integratorsb/ndds/hw/pcb_v4.JPG

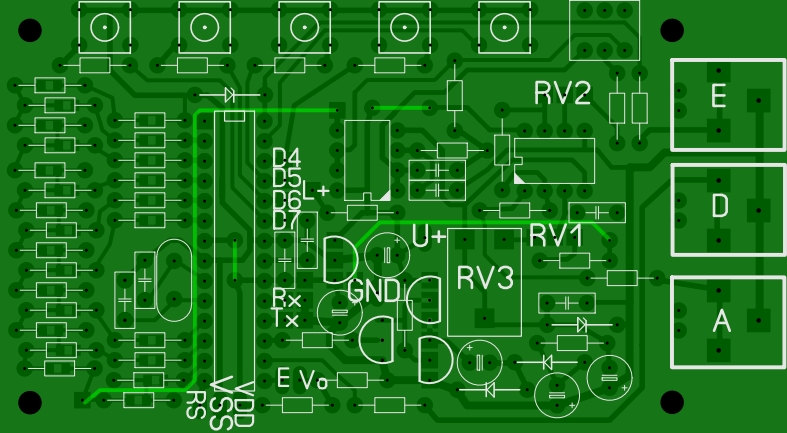
hw/pcb_v4.JPG
