integratorsb/ndds/version.txt

v0.17 - 16.06.2018
	Добавлен генератор импульсной последовательности(DPATTERN)
	Исправлен баг в алгоритме PULSE
	Переделана инициализаци портов
	Оптимизация кода

v0.16 - 20.12.2017
	Добавлен свип-генератор(SWEEP)
	Доработан генератор ТВ сигнала
	Исправлена ошибка со сбросом порта в режиме ШУМ(NOISE)
	Сделан сброс настроек для прошивки с энкодером
	Оптимизация кода(таблицы пилы и треугольника теперь генерируются математическим методом)

v0.15 - 4.11.2017
	Добавлен генератор двухтонального сигнала(DTMF)
	Сделана версия прошивки с энкодером
	Оптимизация кода
	На порт PB5 выводится лог. 0 при работе в аналоговом режиме и 1 в цифровом
	- Отключен программный UART

v0.14 - 17.10.2017 
	Исправлена ошибка с инициализацией ШИМ
	Режим работы генератора теперь можно выбирать кнопками +/- 
	
v0.13 - 29.09.2017 
	Исправлен баг с переполнением в режимах с DDS
	Исправлен баг с делителем ШИМ
	Добавлено ещё 2 ТВ сигнала(сетка и клетчатое поле)
	В режиме ШИМ(без синхронизации) теперь можно менять частоту и скважность во время работы генератора

v0.12 - 19.09.2017 
	Исправлено несколько багов

v0.11 - 10.09.2017 
	Исправлен глюк кнопок
	Добавлена возможность запуска по внешнему сигналу в режим pulse
	Добавлена возможность внешней синхронизации в режим pwm
	Оптимизация кода

v0.1 - 27.07.2017 
	Первая версия
