integratorsb/ndds/hw/dds_sg_1.png

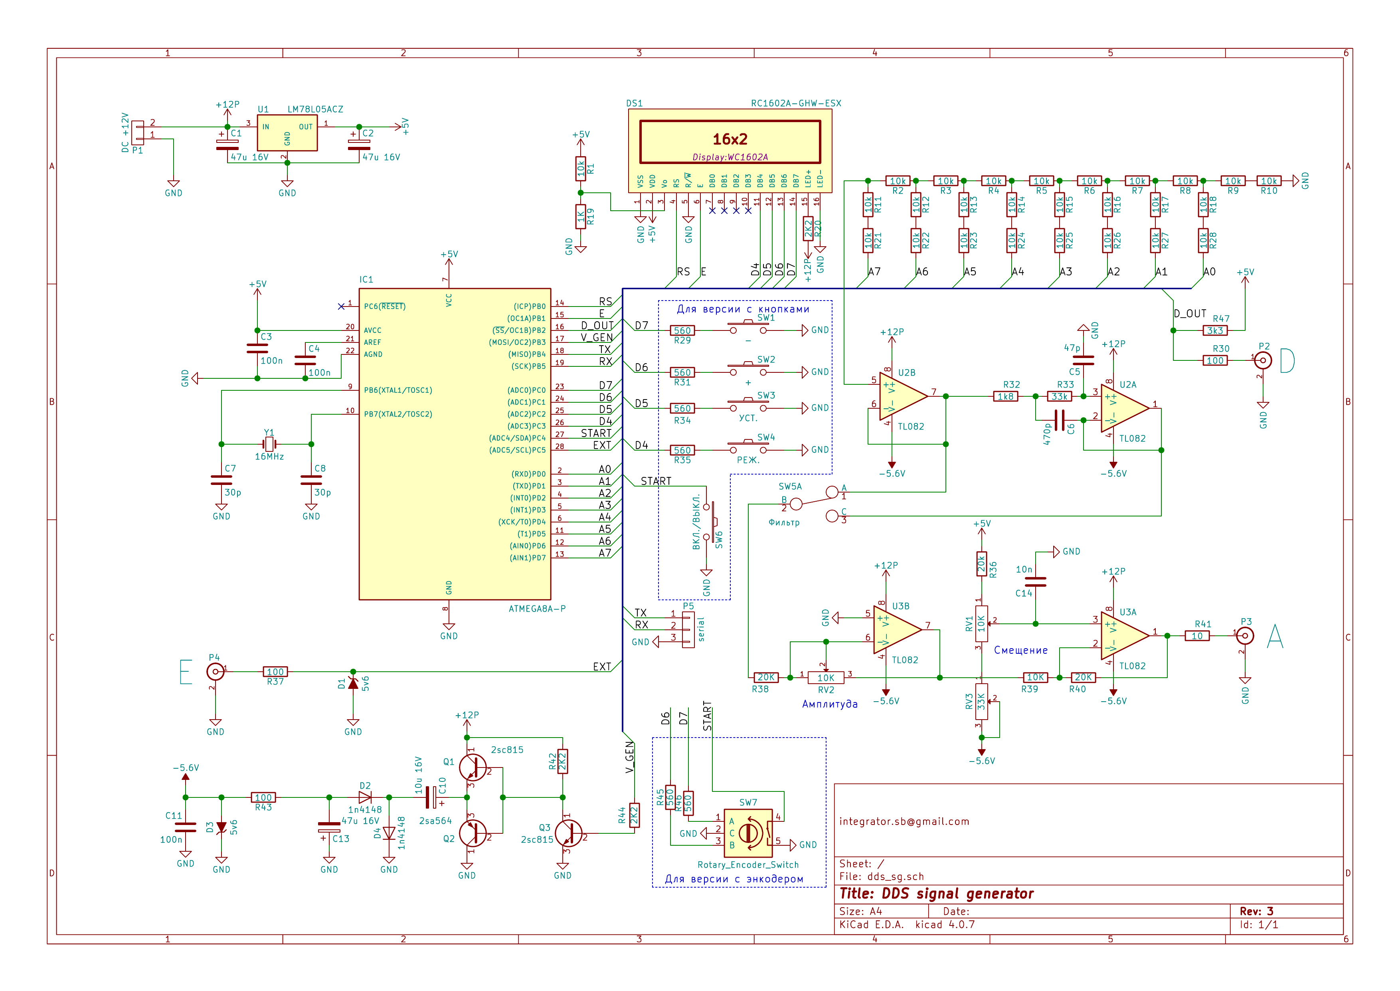
hw/dds_sg_1.png
