integratorsb/ndds/hw/dds_sg.pdf

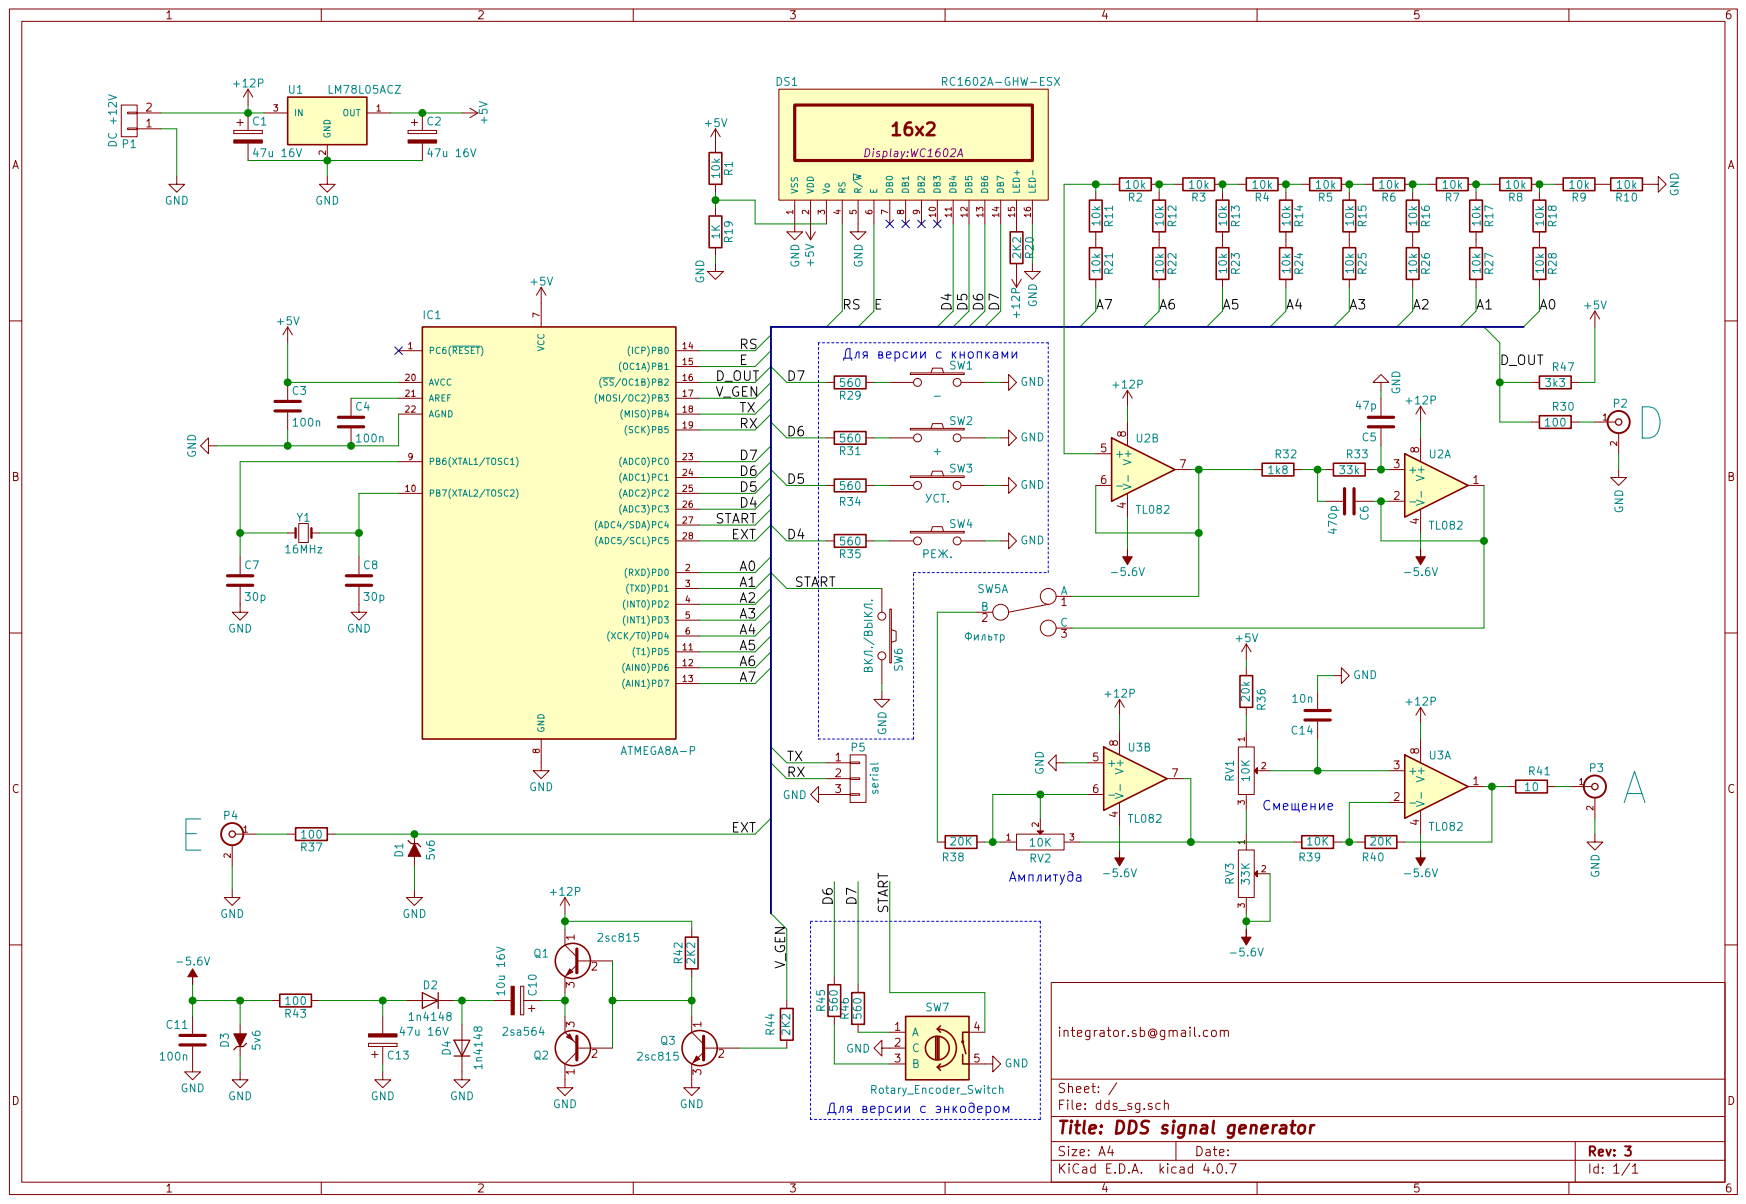
[picture p3: page 1]
