integratorsb/ndds/(list of files, drawings)

Other design files:
hw/pcb_v5.lay
