integratorsb/ndds/main.c

/*
 * main.c
 *
 * Created: 10.07.2017 1:17:10
 *  Author: integrator.sb@gmail.com
 */ 

#include "config.h"
//#include <stdio.h>
#include <stdlib.h>
#include <avr/io.h>
#include <avr/pgmspace.h>
#include <avr/eeprom.h>
#include <avr/interrupt.h>
#include <util/delay.h>
#include <inttypes.h>
#include "hd44780.h"
#include "menu.h"
#include "suart.h"
#include "dds_rout.h"
#include "TV_video_generator.h"


const gen_t PROGMEM def_setting = DEF_SETTING;
gen_t EEMEM setting = DEF_SETTING;
EEMEM uint8_t e_pattern[256] = DEF_DPATTERN;

uint8_t __attribute__ ((section (".buffer"))) buf[256]; 


const uint8_t  sinewave[] PROGMEM= 
{
	0x80,0x83,0x86,0x89,0x8c,0x8f,0x92,0x95,0x98,0x9c,0x9f,0xa2,0xa5,0xa8,0xab,0xae,
	0xb0,0xb3,0xb6,0xb9,0xbc,0xbf,0xc1,0xc4,0xc7,0xc9,0xcc,0xce,0xd1,0xd3,0xd5,0xd8,
	0xda,0xdc,0xde,0xe0,0xe2,0xe4,0xe6,0xe8,0xea,0xec,0xed,0xef,0xf0,0xf2,0xf3,0xf5,
	0xf6,0xf7,0xf8,0xf9,0xfa,0xfb,0xfc,0xfc,0xfd,0xfe,0xfe,0xff,0xff,0xff,0xff,0xff,
	0xff,0xff,0xff,0xff,0xff,0xff,0xfe,0xfe,0xfd,0xfc,0xfc,0xfb,0xfa,0xf9,0xf8,0xf7,
	0xf6,0xf5,0xf3,0xf2,0xf0,0xef,0xed,0xec,0xea,0xe8,0xe6,0xe4,0xe2,0xe0,0xde,0xdc,
	0xda,0xd8,0xd5,0xd3,0xd1,0xce,0xcc,0xc9,0xc7,0xc4,0xc1,0xbf,0xbc,0xb9,0xb6,0xb3,
	0xb0,0xae,0xab,0xa8,0xa5,0xa2,0x9f,0x9c,0x98,0x95,0x92,0x8f,0x8c,0x89,0x86,0x83,
	0x80,0x7c,0x79,0x76,0x73,0x70,0x6d,0x6a,0x67,0x63,0x60,0x5d,0x5a,0x57,0x54,0x51,
	0x4f,0x4c,0x49,0x46,0x43,0x40,0x3e,0x3b,0x38,0x36,0x33,0x31,0x2e,0x2c,0x2a,0x27,
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
	#endif
	
	//DDRC =  0<<EXT_PIN;
	PORTC = BTN_MASK | 0<<EXT_PIN;
	
	//R2RPORT = 0;
	//R2RDDR = 0xff;
}


inline void noise_start()
{
	while(!btnCheck(BTN_START))
	{
		R2RPORT = rand();
	}
	io_to_default();
}

void pwm_stop()
{
	TCCR1A = 0;
	TCCR1B = 0;
	io_to_default();
}


void pwm_start(uint32_t freq, uint8_t d, uint8_t e )
{
	uint32_t period;
	uint8_t cntr;
	
	
	//fast PWM	
	TCCR1A |= (1<<WGM11);
	TCCR1B |= (1<<WGM13)  | (1<<WGM12);

	period = (F_CPU/freq) - 1;	
	
	cntr = (TCCR1B & 0b11111000);

	if(period < 0xffff)
	{
		
		//cntr = (TCCR1B & 0b11111000) | (1<<CS10);//без делителя
		cntr |= (1<<CS10);//без делителя
	}
	else
	{
		period /= 256;
		//cntr = (TCCR1B & 0b11111000) | (1<<CS12);//делитель 256
		cntr |= (1<<CS12);//делитель 256
		
	}
	
	ICR1 = (uint16_t)period;
	OCR1B =  (uint16_t)(period * d / 100);	
	TCCR1B = cntr;
	
	TCCR1A |= (1<<COM1B1);

	//	if(e == EXT_NO)
	//		return;
	if(e == EXT_HIGH)
	{
		while(!btnCheck(BTN_START))
		{
			if((EXT_PINS & EXT_PIN_MSK) != 0)
				TCCR1A |= 1<<COM1B1;
			else
				TCCR1A &= ~(1<<COM1B1);
		}
	}
	else if(e == EXT_LOW)
	{
		while(!btnCheck(BTN_START))
		{
			if((EXT_PINS & EXT_PIN_MSK) == 0)
				TCCR1A |= 1<<COM1B1;
			else
				TCCR1A &= ~(1<<COM1B1);
		}
	}
	//else return;
	//pwm_stop();
}

uint8_t pwm_is_run() 
{
	return (TCCR1B != 0);
}

uint32_t get_phase_f(uint32_t f)
{
	//return ((uint64_t)f << 16) / (F_CPU/NUM_CYCLES/0x100);
	//return (((uint64_t)f<<24 )/(F_CPU/NUM_CYCLES));	
	return (((uint64_t)f * (0x1000000*NUM_CYCLES) )/F_CPU);

}

inline void dds_start(uint32_t f)
{

	dds(get_phase_f(f));
	io_to_default();
}

inline void ddssq_start(uint32_t f)
{

	//HSPORT &= ~(1<<HSPIN);
	//HSDDR |= 1<<HSPIN;
	dds_sq(get_phase_f(f) * 2);
	//HSPORT &= ~(1<<HSPIN);
	//HSDDR &= ~(1<<HSPIN);
	io_to_default();

}


void get_phase_t( uint32_t *p, uint32_t *t)
{
/*
	 T0 = 1000000<<16 / (F_CPU / NUM_CYCLES)
	 P = 1<<24 / (T<<16 / T0)*/
	//*p =  0x1000000/(((uint64_t)*t<<16)/((uint64_t)(1000000<<16) / (F_CPU / NUM_CYCLES)));
	//*p =  0x1000000/(((uint64_t)*t<<16)/36864);	
	//*p = ((1000000 * (uint64_t)NUM_CYCLES * 0x1000000) / F_CPU) / *t;
	*p = ((1000000 * (uint64_t)NUM_CYCLES * 0x100000000) / F_CPU) / *t;
	
}

inline void pulse_start()
{
	pulse_t pulse_s;
	
	get_phase_t(&pulse_s.t_rise, &generator.pulse_t_rise);
	get_phase_t(&pulse_s.t_on,&generator.pulse_t_on);
	get_phase_t(&pulse_s.t_fall,&generator.pulse_t_fall);
	get_phase_t(&pulse_s.t_off,&generator.pulse_t_off);
	pulse_s.n = generator.pulse_n;
	pulse(&pulse_s);
	io_to_default();

}

inline uint8_t trig_wait_rise()
{
	while((EXT_PINS & EXT_PIN_MSK) != 0)
	{
		if(btnCheck(BTN_START)) return 0;
	}
	while((EXT_PINS & EXT_PIN_MSK) == 0)
	{
		if(btnCheck(BTN_START)) return 0;
	}
	return 1;
}

inline uint8_t  trig_wait_fall() 
{
	while((EXT_PINS & EXT_PIN_MSK) == 0)
	{
		if(btnCheck(BTN_START)) return 0;
	}
	while((EXT_PINS & EXT_PIN_MSK) != 0)
	{
		if(btnCheck(BTN_START)) return 0;
	}
	return 1;
}

void save_mode()
{
	eeprom_update_byte(&setting.m, generator.m);
}

void mode_select(uint8_t btn)
{

	if(btn == BTN_MODE || btn == BTN_UP)
		generator.m++;
	else if(btn == BTN_DOWN)
	{
		if(generator.m == 0)
			generator.m = M_VER;
		else
			generator.m--;
	}
}

void load_table(const uint8_t* src)
{
	memcpy_P(&buf, src, sizeof(buf));
}


inline void dtmf_start()
{
	load_table(sinewave);
	
	dtmf((uint64_t)(generator.dtmf_f1<<16) /(F_CPU/21/0x100), \
	(uint64_t)(generator.dtmf_f2<<16) /(F_CPU/21/0x100));
	io_to_default();
}



void dds_main(const char* t, uint32_t* f, uint32_t* f_save)
{
	uint8_t btn;
	
	#ifdef USE_OMUX
		omux_clr();
	#endif
	nnl_puts_P(t);
	print_on_off(0);			
	print_fq(*f);
	btn = btn_wait();
	if(btn == BTN_START)
	{
		btn_wait_up_start();
		eeprom_update_dword(f_save, *f);
		save_mode();
		print_on_off(1);
		dds_start(*f);
		btn_wait_up_start();
	}
	else if(btn == BTN_SET)
	{
		input_f(f);
	}
	mode_select(btn);
}

inline void noise_main()
{
	uint8_t btn;
	
	#ifdef USE_OMUX
		omux_clr();
	#endif
	nnl_puts_P(PSTR("\rNOISE "));
	print_on_off(0);
	
	btn = btn_wait();
	if(btn == BTN_START)
	{
		btn_wait_up_start();
		save_mode();
		print_on_off(1);
		noise_start();
		btn_wait_up_start();
	}
	mode_select(btn);
}

inline void sqw_main()
{
	uint8_t btn;
	
	#ifdef USE_OMUX
	omux_set();
	#endif
	nnl_puts_P(PSTR("\rSQUARE WAVE"));
	print_on_off(0);
	print_fq(generator.f_sqw);
						
	btn = btn_wait();
	if(btn == BTN_START)
	{
		btn_wait_up_start();
		save_mode();
		eeprom_update_dword(&setting.f_sqw, generator.f_sqw);

		print_on_off(1);
		ddssq_start(generator.f_sqw);
		btn_wait_up_start();
	}
	else if(btn == BTN_SET)
	{
		input_f(&generator.f_sqw);
	}
	mode_select(btn);
}

inline void pwm_main()
{
	uint8_t btn;
	
	#ifdef USE_OMUX
	omux_set();
	#endif
	io_to_default();
	//st = pwm_is_run();
	
	nnl_puts_P(PSTR("\rPWM"));
	print_on_off(pwm_is_run());
	print_fq(generator.pwm_f);
	nnl_puts_P(PSTR(" D="));
	print_u8(generator.pwm_d);
	if(generator.pwm_sync == EXT_HIGH)
		nnl_puts_P(PSTR(" E=H"));
	else if(generator.pwm_sync == EXT_LOW)
		nnl_puts_P(PSTR(" E=L"));
					
	btn = btn_wait();
	if(btn == BTN_START)
	{
		btn_wait_up_start();
						
		if( pwm_is_run())
		{
			pwm_stop();
		}
		else
		{

			print_on_off(1);
			pwm_start(generator.pwm_f, generator.pwm_d, generator.pwm_sync );
			save_mode();
			eeprom_update_block(&generator.pwm_f,&setting.pwm_f, 1+4+1);
		}
	}
	else if(btn == BTN_SET)
	{
		input_f(&generator.pwm_f);
		input_dc();
		if(!pwm_is_run())
			generator.pwm_sync = input_ext_sync();
	}
	if(!pwm_is_run())
		mode_select(btn);

}

inline void hs_main()
{
	uint8_t btn;
	
	#ifdef USE_OMUX
	omux_set();
	#endif
	nnl_puts_P(PSTR("\rHIGH SPEED"));
	print_on_off(0);
	print_fq(generator.hs_f);
	btn = btn_wait();
	if(btn == BTN_START)
	{
		btn_wait_up_start();
		save_mode();
		eeprom_update_dword(&setting.hs_f, generator.hs_f);
		print_on_off(1);
		pwm_start(generator.hs_f, 50, 0);
		while(!btnCheck(BTN_START)){};
		pwm_stop();
		btn_wait_up_start();
	}
	else if(btn == BTN_SET)
	{
		input_hs();
	}
	mode_select(btn);
}

inline void pulse_main()
{
	uint8_t btn;
	
	#ifdef USE_OMUX
	omux_clr();
	#endif
	
	nnl_puts_P(PSTR("\rPULSE "));
	if(generator.pulse_trig == TR_RISE)
		nnl_puts_P(PSTR("T:R"));
	else if(generator.pulse_trig == TR_FALL)
		nnl_puts_P(PSTR("T:F"));
	print_on_off(0);		
	print_t(generator.pulse_t_rise + generator.pulse_t_fall\
	+ generator.pulse_t_on + generator.pulse_t_off);

	
/*
	nnl_puts_P(PSTR("\rPULSE\nT="));
	print_t(generator.pulse_t_rise + generator.pulse_t_fall\
		 + generator.pulse_t_on + generator.pulse_t_off);
	if(generator.pulse_trig == TR_RISE)
		nnl_puts_P(PSTR(" T:R"));
	else if(generator.pulse_trig == TR_FALL)
		nnl_puts_P(PSTR(" T:F"));*/

	
	btn = btn_wait();
	if(btn == BTN_START)
	{
		btn_wait_up_start();
		save_mode();
		eeprom_update_block(&generator.pulse_t_rise, &setting.pulse_t_rise,
		4 * sizeof(generator.pulse_t_rise) + sizeof(generator.pulse_n) + sizeof(generator.pulse_trig));
	

		lcd_goto(13);
		if(generator.pulse_trig == TR_RISE)
		{
			nnl_puts_P(PSTR("W:R"));
			if(trig_wait_rise() == 0)
				goto p_cancel;
			//break;
		}
		else if(generator.pulse_trig == TR_FALL)
		{
			nnl_puts_P(PSTR("W:F"));
			if(trig_wait_fall() == 0)
				goto p_cancel;
			//break;
		}
		print_on_off(1);
		pulse_start();
		p_cancel:
		btn_wait_up_start();
	}
	else if(btn == BTN_SET)
	{
		input_t(&generator.pulse_t_rise,PSTR("\rTrise="));
		input_t(&generator.pulse_t_on,PSTR("\rTon="));
		input_t(&generator.pulse_t_fall,PSTR("\rTfall="));
		input_t(&generator.pulse_t_off,PSTR("\rToff="));
		input_n();
		generator.pulse_trig = input_trig();
	}
	mode_select(btn);	
}

inline void tv_main()
{
	const char* tv_type[] = {
		PSTR("VERTICAL BARS"),
		PSTR("LATTICE"),
		PSTR("CHESSBOARD")
	};
	uint8_t btn;
	
	#ifdef USE_OMUX
	omux_clr();
	#endif
	if(generator.tv_type > TV_CHESSBOARD)
		generator.tv_type = 0;
	
	nnl_puts_P(PSTR("\rTV VIDEO\n"));
	nnl_puts_P(tv_type[generator.tv_type]);
	print_on_off(0);
	btn = btn_wait();
	if(btn == BTN_START)
	{
		btn_wait_up_start();
		save_mode();
		eeprom_update_byte(&setting.tv_type, generator.tv_type);
		
		print_on_off(1);
		tv_gen(generator.tv_type);

		btn_wait_up_start();
	}
	else if(btn == BTN_SET)
	{
		generator.tv_type++;
	}
	mode_select(btn);
}

inline void dtmf_main()
{
	uint8_t btn;
	
	#ifdef USE_OMUX
	omux_clr();
	#endif
	nnl_puts_P(PSTR("\rDTMF"));
	print_on_off(0);
	print_fq(generator.dtmf_f1);
	n_putchar(' ');
	print_fq(generator.dtmf_f2);
	
	btn = btn_wait();
	if(btn == BTN_START)
	{
		btn_wait_up_start();
		save_mode();
		
		eeprom_update_block(&generator.dtmf_f1, &setting.dtmf_f1, sizeof(generator.dtmf_f1)*2);
		
		print_on_off(1);
		dtmf_start();

		btn_wait_up_start();
	}
	else if(btn == BTN_SET)
	{
		input_fd(PSTR("\rF1="), &generator.dtmf_f1);
		input_fd(PSTR("\rF2="), &generator.dtmf_f2);
	}
	mode_select(btn);
	
}

inline void sweep_main()
{
	uint8_t btn;
	
	#ifdef USE_OMUX
	omux_clr();
	#endif
	//HSDDR |= 1<<HSPIN;
	nnl_puts_P(PSTR("\rSWEEP"));
	print_on_off(0);
	print_fq(generator.sweep_fs);
	n_putchar('>');
	print_fq(generator.sweep_fe);

	btn = btn_wait();
	if(btn == BTN_START)
	{
		btn_wait_up_start();
		save_mode();
		load_table(sinewave);
		eeprom_update_block(&generator.sweep_fs, &setting.sweep_fs,
		3 * sizeof(generator.sweep_fs));
		print_on_off(1);		

		do
		{
			sweep(get_phase_f(generator.sweep_fs),\
				get_phase_f(generator.sweep_fe),\
				get_phase_f(generator.sweep_fi));
		} while (!btnCheck(BTN_START));
		io_to_default();
		print_on_off(0);
		btn_wait_up_start();
	}
	else if(btn == BTN_SET)
	{
		input_fd(PSTR("\rFstart="),&generator.sweep_fs);
		input_fd(PSTR("\rFend="), &generator.sweep_fe);
		input_fd(PSTR("\rFinc="), &generator.sweep_fi);
	}
	mode_select(btn);
}


// заполняет таблицу для пилы
// значение аргумента 1 - прямая пила, -1 обратная
void load_sawtooth_wf(int8_t a)
{

	uint8_t i = 0, b = 0;

	do 
	{
		buf[i] = b;
		b += a;
		i++;
	} while (i);
}

inline void load_triangle_wf()
{
	uint8_t i = 1,  b = 1;

	while(i)
	{
		buf[i] = b;
		if(i<128)
			b += 2;
		else
			b -= 2;	
			
		i++;	
	}
	buf[i] = 0;
}


inline void dpattern_d(uint32_t t0)
{
	uint8_t  i = 0;
	int8_t p;
	uint32_t t;
	

	
	TCCR1A = 0;
	//вычисляем число циклов таймера для t0	
	t = t0 * (F_CPU/1000000) - 1;

	if(t < 0xFFFF)
	{
		TCCR1B = 1<<WGM12 | 0<<CS12 | 0<<CS11 | 1<<CS10; // CTC без делителя	
	}
	else 
	{
		TCCR1B = 1<<WGM12 | 1<<CS12 | 0<<CS11 | 0<<CS10; // CTC делитель 256
		t /= 256;
	}	
	OCR1A = t;	

	while(1)
	{
		p = buf[i++];
		if(p == CMD_REP)
		{
			if(i == 0)//выход, если команда повтора идет первой
				p = CMD_BRK;
			i = 0;
			continue;
		}	
		else if (p == CMD_BRK)
			break;
		else if(p > 0)
		{
			HSDDR &= ~(1<<HSPIN);			
		}
		else
		{
			HSDDR |= (1<<HSPIN);
			p = -p;
		}
		
		//TIFR |= (1<<OCF1A);
		//_delay_us(5);	
			
		while(p != 0)
		{
			TIFR |= (1<<OCF1A);			
			while(!(TIFR & (1<<OCF1A)))
			{
				if(btnCheck(BTN_START))	goto dpattern_stop;
			}
			p--;
		}
		
	}
dpattern_stop:
	HSDDR &= ~(1<<HSPIN);
	TCCR1B = 0;
}

inline void dpattern_main()
{

	uint8_t btn;
	
	#ifdef USE_OMUX
	omux_set();
	#endif
	
	HSDDR &= ~(1<<HSPIN);
	HSPORT &= ~(1<<HSPIN);
	
	nnl_puts_P(PSTR("\rDPATTERN\nT0="));	
	print_t(generator.dpattern_t);
	print_on_off(0);	
	
	btn = btn_wait();
	if(btn == BTN_START)
	{
		btn_wait_up_start();
		
		eeprom_read_block(buf, e_pattern, sizeof(buf));
		save_mode();
		eeprom_update_dword(&setting.dpattern_t, generator.dpattern_t);
		
		print_on_off(1);
		
		dpattern_d(generator.dpattern_t);

		btn_wait_up_start();
	}
	else if(btn == BTN_SET)
	{
		input_t(&generator.dpattern_t,PSTR("\rT0="));
		//generator.dpattern_mode = input_io_mode();
		input_dpattern();
		
	}
	mode_select(btn);
	if(generator.m  != M_DPATTERN)
	{
		io_to_default();
	}
}



int main()
{

	
	io_init();	
	_delay_ms(20);





#ifndef USE_ENCODER
	// сброс настроек при включении с зажатой кнопкой BTN_SET
	
	uint8_t  c = 50;
	while(btnCheck(BTN_SET))
	{

		_delay_ms(100);
		c--;
		if(c == 0)
		{
			//db_puts("reset to default");
			btn_wait_up(BTN_SET);
			memcpy_P(&generator, &def_setting, sizeof(generator));
			eeprom_update_block(&generator, &setting, sizeof(generator));
			break;
		}
/*
		_delay_ms(5000);
		if(btnCheck(BTN_SET))
		{
			//db_puts("reset to default");
			btn_wait_up(BTN_SET);
			memcpy_P(&generator, &def_setting, sizeof(generator));
			eeprom_update_block(&generator, &setting, sizeof(generator));
			break;
		}*/
	}
#else
	//сброс настроек при включении с зажатой кнопкой BTN_START
		
	uint8_t  c = 50;
	while(btnCheck(BTN_START))
	{
		c--;
		_delay_ms(100);
		if(c == 0)
		{
			//db_puts("reset to default");
			btn_wait_up(BTN_START);
			memcpy_P(&generator, &def_setting, sizeof(generator));
			eeprom_update_block(&generator, &setting, sizeof(generator));
			break;
		}
	}
#endif	

#ifdef VGEN_ENABLE
	vgen_on();
	_delay_ms(100);
#endif
	lcd_init();
	lcd_clrscr();
	eeprom_read_block(&generator, &setting, sizeof(generator));

	while(1)
	{
		switch(generator.m)
		{
			case M_SINW:
				load_table(sinewave);
				dds_main(PSTR("\rSINE "),&generator.f_sine, &setting.f_sine);
				break;
				
			case M_STW:
				//memcpy_P(&buf, sawtoothwave, sizeof(buf));
				load_sawtooth_wf(1);
				dds_main(PSTR("\rSAWTOOTH "),&generator.f_stw, &setting.f_stw);
				break;
				
			case M_RSTW:
				//memcpy_P(&buf, rsawtoothwave, sizeof(buf));
				load_sawtooth_wf(-1);
				dds_main(PSTR("\rRSAWTOOTH "),&generator.f_rstw, &setting.f_rstw);
				break;
				
			case M_TRW:
				//memcpy_P(&buf, trianglewave, sizeof(buf));
				load_triangle_wf();
				dds_main(PSTR("\rTRIANGLE "),&generator.f_trw, &setting.f_trw);
				break;
				
			case M_ECG:
				load_table(ECG);
				dds_main(PSTR("\rECG "),&generator.f_ecg, &setting.f_ecg);
				break;
				
			case M_NOISE:
				noise_main();
				break;
				
			case M_SQW:	
				sqw_main();
				break;
				
			case M_SQPWM:
				pwm_main();
				break;
				
			case M_HSSQW:
				hs_main();
				break;
				
			case M_PULSE:
				pulse_main();
				break;
				
			case M_TV:
				tv_main();
				break;
				
			case M_DTMF:
				dtmf_main();
				break;
				
			case M_SWEEP:
				sweep_main();
				break;

			case M_DPATTERN:
				dpattern_main();
				break;

			case M_VER:
				nnl_puts_P(PSTR("\rNDDS VER"FW_VER"\nSIGNAL GENERATOR"));
				mode_select(btn_wait());
				break;
				
			default:
				generator.m = M_SINW;
				break;
		}
	}
	
	return 0;
}
